Xxfliph/cycloidal-foc-actuator/host/README.md

# Host Tools

Python tools that talk to the actuator over CAN (CANable 2.0 + `python-can`):
- Send position/velocity commands.
- Log telemetry.
- Run automated step tests and plot results.
