Xxfliph/cycloidal-foc-actuator/sim/README.md

# Simulation

Python scripts for:
- FOC simulation (motor model + control loops), used to compare against hardware step responses.
- Cycloid disc profile generation from parametric equations, exported for the SolidWorks equation-driven curve.

Save generated plots to `../docs/img/`.
