Xxfliph/cycloidal-foc-actuator/docs/log.md

# Build Log

One entry per work session. Write what you did, what broke, and what you decided. This becomes the "what broke and how I fixed it" section of the README.

---

## 2026-10-17
- Created repository and folder structure.

## 2026-10-2 to 2026-11-01 Learn FOC
- How a BLDC motor works (3 phases, pole pairs, GM3506)
- Six-step drive vs. FOC
- Core FOC idea: field 90° ahead of the magnet, d–q frame
- Current mode vs. voltage mode (back-EMF, why voltage mode first)
- PI control and cascaded loops
- Clarke and Park transforms (and their inverses)
- Sine PWM vs. SVPWM (+15% voltage, the hexagon)
- Center-aligned PWM on TIM1

## 2026-10-29: CubeMX/CubeIDE setup
- CubeIDE 2.x + standalone CubeMX; G474 project, 8 MHz HSE → PLL → 170 MHz, SWD, HAL tick on TIM6 (FreeRTOS later)
- C++ entry point app_main() in app.cpp
- USB CDC logging (HSI48 + CRS) → COM10
- TIM1 center-aligned 3-ch PWM, ARR 4250 → 20 kHz, verified 25/50/75% in PulseView (Zadig/WinUSB needed for this USB logic analyzer)
- Decided: pin map (PA8/9/10 PWM, PB0 DRV_EN, PA11/12 USB, PA15/PB7 I2C1); avoid PB8 (BOOT0)

## 2026-10-31: MT6701 and I2C test
- My MT6701 breakout doesn’t expose the SSI pins, so I’m using I2C (~8 kHz reads) for now; SSI on the custom PCB.
- I2C1 at 400 kHz on PA15/PB7; bus scan found the MT6701 at 0x06

## 2026-11-01: Writing FOC firmware
- FocController::computeDuties: inverse Park → inverse Clarke → SVPWM (min–max injection) → duties; ±6 V software limit (below the 8.66 V SVPWM max on 15 V)
- MotorDriver: CCR writes, PWM start, enable pin. Kept separate from the math so FocController is testable without hardware
- Verified SVPWM saddle waveforms on Serial Plotter: 154–846 ‰ at vq = 6 V / 15 V bus, matching 0.5 ± (√3/2)·vq/vbus
- Broke: max/min selection used strict `>`, so a two-way tie picked the smallest value as the max. Fixed with `>=`
- Broke: sign error in inverse Park Vβ (would reverse rotation); caught by checking θe = 0
- Broke: local `vbus` shadowed the member; member-name typos (vLimit vs vLimit_)
- Broke: newlib-nano can't printf floats → printed value ×1000 as int (alternative: -u _printf_float)

## 2026-11-02 - 2026-11-03: MT6701 Encoder - Encoder class, multi-turn, velocity

### Raw I2C read
- Angle = 14 bits across two registers: 0x03 = bits 13..6, 0x04 = bits 5..0 (in its upper 6 bits; low 2 bits ignored).
  `count = (reg03 << 6) | (reg04 >> 2)` → 0..16383 per mechanical turn (~0.022°/count).
- One `HAL_I2C_Mem_Read` of 2 bytes from 0x03 (register auto-increments), so both bytes come from the same
  sample. Two separate reads could stitch old + new bytes (~64-count glitch → velocity spike).
- HAL wants the 8-bit address form: 0x06 << 1 = 0x0C (R/W bit goes in bit 0). Plain 0x06 → HAL_ERROR.
- Timeout 5 ms (not HAL_MAX_DELAY) so a stuck bus can't freeze the loop while PWM keeps running.

### Encoder bench results (magnet by hand / taped, motor unpowered)
- Magnet hand-held over chip side: ~50 counts jitter (~1.1° mech ≈ 12° electrical).
- Magnet on back of board (PCB as spacer) or stuck to a header pin: ±1 count = sensor noise floor.
  → Gap and centring matter a lot: design a fixed ~1–2 mm, centred magnet gap into the mount.
- No magnet: random values (±~80 counts) but every read still HAL_OK.
  → "Bus worked" ≠ "data valid". TODO: read MT6701 field-strength status later.
- Turning: sawtooth 0 → 16383, wraps to 0. Screenshot: docs/img/<sawtooth>.png

### Encoder class (firmware/actuator_fw/Core/{Inc,Src}/encoder.*)
- `Encoder(I2C_HandleTypeDef* hi2c, uint8_t addr)`: takes the datasheet 7-bit address, shifts once in the
  initializer list.
- `update()`: one I2C read per call; updates state only on HAL_OK (keeps last good value on failure);
  returns the HAL status. Getters are const and never touch the bus, so each loop reads once and every
  user sees the same sample.
- `getRawCount()`, `getAngle()` (rad, 0..2π), `getMultiTurnAngle()` (rad, unbounded),
  `getRawVelocity()`, `getVelocity()` (filtered, rad/s).

### Multi-turn (unwrap)
- diff = new − prev (as int32_t); if diff > 8192 → −16384; if diff < −8192 → +16384; else unchanged.
  Always assumes the shorter way round, so the shaft must move < half a turn between reads
  (10 ms loop → max 50 rev/s; faster loop raises the limit). Threshold must be exactly half a turn.
- totalCount_ (int32_t) accumulates corrected diffs. First good read seeds prev/total (no fake jump).
- Verified: multi-turn angle climbs/falls smoothly across wraps, goes negative past start.

### Timing: DWT cycle counter
- Enabled once in app_main: `CoreDebug->DEMCR |= TRCENA`, `DWT->CTRL |= CYCCNTENA`.
  Read `DWT->CYCCNT` (170 MHz, ~6 ns resolution, wraps every ~25 s; unsigned subtraction handles the wrap).
- Measured loop period: ~1,870,000 cycles = 11.0 ms, not 10 ms (HAL_Delay adds a tick).
  Assuming 10 ms would have made velocity ~10% wrong → always measure Δt.

### Velocity
- velocity = (unwrapped diff → rad) / Δt, Δt = Δcycles / SystemCoreClock (float). Guard Δcycles > 0
  (avoids NaN, e.g. if the counter was never enabled).
- Still test: raw velocity is exactly 0 / ±34 mrad/s = ±1 count per 11 ms ((2π/16384)/0.011 ≈ 34.9).
  Matches prediction → angle conversion and Δt are correct.
- No-magnet test: ±4000 mrad/s (≈ ±115 counts per sample) → velocity amplifies angle noise.
  Faster loops make this worse (1 count at 1 kHz ≈ 380 mrad/s).

### Velocity low-pass filter (EMA)
- filt += α·(raw − filt), with α = Δt / (τ + Δt), τ = 20 ms. α recomputed each update from the measured Δt,
  so the reaction time stays ~τ regardless of loop rate or missed reads.
- At 11 ms: α ≈ 0.355. Still-test noise ±34 → ~±15 mrad/s; first step = 0.355 × 34 ≈ 12 and
  decay ×0.645 per step, both match the plot.
- Hand-spin test: filt is smoother, lags raw by ~1–2 samples (~20 ms), and shaves peaks
  (4200 → 3800, −6900 → −5800). Trade-off: bigger τ = smoother but laggier.
  Screenshot: docs/img/<raw_vs_filt>.png

## 2026-11-03 - 2026-11-04: First spin, calibration, closed-loop code

### Electrical angle (FocController)
- Added pole pairs, offset and direction to FocController (Encoder stays a pure sensor).
  `electricalAngle(mech) = fmodf(mech·11·dir − offset, 2π)`, +2π if negative.
- Verified by hand: elec = 11 × mech (mod 2π) at 5 positions.

### Dev rig + first open-loop spin (WARG bay bench supply)
- Keysight EDU36311A CH2: 12 V, 0.5 A limit → SimpleFOC Mini +/− screw terminal.
  Signals: PA8/PA9/PA10 → IN1/IN2/IN3, PB0 → EN, common GND. nRT/nSP/nFT/3.3V unconnected.
- Power-up with driver disabled: 11 mA.
- Open loop (vd 0, vq 1.5 V, θe +0.07 rad/loop): smooth spin, ~0.10 A. Reverse works.
- Stutters below vq ≈ 0.3–0.4 V (friction/cogging).
- Habit: supply output OFF before every flash.

### Encoder on the motor
- First try: flat encoder reading → magnet was on a part that doesn't rotate.
  Magnet must spin with the rotor, centred on the axis; chip fixed, facing it.
- Open-loop ramp vs encoder: same slope and direction → direction +1, 11 pole pairs.

### Calibration
- Hold vd at θe = 0 for 1 s, read encoder → offset; setCalibration(offset, +1).
- Mistake 1: calibrated with motor power off (firmware runs right after flashing) → wrong offset.
  Fix: output ON, then press NRST.
- Mistake 2: vd = 1.5 V too weak → friction/cogging left the rotor ~0.9 rad (electrical) off.
  Fix: calibrate at vd = 2.5 V.
- Verified: holding θe at 0 / π/2 / π / 3π/2 → encoder read 0 / 1570 / 3141 / 4712 mrad
  (within ~1 mrad). Offset ≈ 1.1 rad.

### Closed-loop voltage-mode FOC (written, compiles, not yet tested)
- Calibrate at boot (fail → driver off, print "cal failed"), then loop with no delay:
  encoder → θe → computeDuties(vd 0, vq 1 V, θe) → setDuty.
- 20 consecutive failed encoder reads → driver off (latched until reset).

### Encoder magnet choice
- Noise test (spread = max − min over 50 still reads):
  - off-centre, next to a steel header pin: big magnet 20–30, small 60–80
  - centred on the back of the board (~1.6 mm gap): big 0, small 2
- → Using the bigger magnet.
- Mount plan: magnet flush in the shaft end (printed centring)
  MT6701 centred under it at ~1.5–2 mm. Quick bracket/tape rig for now;
  final encoder placement comes with the custom PCB.

### PIController
- `PIController(kp, ki, outLimit)`, `update(error, dt)`, `reset()`.
  Caller computes the error, so it works for the velocity and position loops.
- update(): if dt > 0 → integral += Ki·e·dt, clamped to ±outLimit;
  output = Kp·e + integral, clamped to ±outLimit.
- Anti-windup: clamp the integral itself, not just the output.
  Otherwise a stuck rotor winds it up far past the limit and the motor stays at full vq after release.
- if dt ≤ 0 → skip integration only. reset() → integral = 0 (call after calibration / any disable).

## 2026-11-04 - 2026-11-05: Velocity loop, closed-loop FOC on hardware, tuning

### Velocity loop code
- Velocity PI runs every ~1 ms; FOC runs every pass with the latest vq.
  Timing: lap timer on DWT->CYCCNT (elapsed = now − last, uint32 handles the ~25 s wrap);
  dt = elapsed / 170e6 (measured, not assumed).
- error = target − getVelocity(); vq = PI.update(error, dt). vq and target declared
  before the loop so they persist between passes.
- Step command: target 0 until STEP_DELAY_MS after loop start (HAL_GetTick), then 10 rad/s.
- USE_VELOCITY_LOOP switch: false = constant VQ (FOC test), true = PI sets vq.

### Encoder placement test
- Test app.cpp: per 50 reads prints count, spread (still noise), max jump, direction flips, I2C errors.
- Still: spread 0. Full turn: smooth count, no jump spikes, err 0.
- Flips only when nudging by hand (cogging snap-back); continuous spin → 0 flips. Passes.

### Closed-loop voltage-mode FOC (first hardware test)
- VQ = +1 V: spins by itself at ~17.6 rad/s. VQ = −1 V: ~−17.9 rad/s. Symmetric.
- Slow ±1 rad/s ripple, ~once per revolution (mechanical/placement, not firmware).
- Mistake: vLimit 2 V clipped calibration's vd 2.5 V (computeDuties clamps vd too).
  Fix: FocController vLimit 3 V, PI limit 2 V as the safety cap.
- "cal failed" after an NRST: MT6701 I2C bus stuck (encoder stays powered through NRST).
  Fix: full power cycle (unplug motor power + STM32 USB).

### Velocity loop tuning (step 0 → 10 rad/s)
| Kp  | Ki | Peak | Settles | Notes |
|-----|----|---|---|---|
| 0.1 | 0  | 6.7  | 5.7 | vq 0.42 V = Kp·e (P-only balance point)  |
| 0.2 | 0  | 9.4  | 7.5 | vq hits 2 V limit at the step |
| 0.4 | 0  | 11.8 | 8.6 | rings, vq goes negative (braking) |
| 0.3 | 3  | 11.6 | 10.0 ± 0.35 | chosen: ~16% overshoot, on target ~0.2 s |
- P-only overshoot comes from lag (EMA τ 20 ms vs ~25 ms rise) → limits Kp.
- Integral learns the steady push: vq ~0.6–0.7 V at 10 rad/s, P ≈ 0.
- Pinch test: speed dips, recovers to 10 while still pinched.

## 2026-11-04 - 2026-11-06: PCB prep — DRV8316 datasheet, requirements, parts, pin plan

### DRV8316 datasheet
- Went through pins + typical application, PWM modes, current sensing, variants, thermal pad.
- Learned along the way: FETs and half-bridges, why the high side needs a charge pump,
  decoupling vs bulk caps, buck vs LDO, pull-ups, open-drain, floating inputs, zener clamps.

### Key decisions
- 3.3 V from the DRV8316's buck at its default 3.3 V, straight to the STM32 (47 µH inductor, ~72 mA budget).
- nSLEEP woken from VM (10 kΩ + 3.3 V zener), not connected to the STM32 → firmware can't cut its own power.
- 3x PWM mode: TIM1 CH1–3 → INHx (same as dev rig), all INLx on one enable GPIO.
- DRV8316CR (newer "C", better current-sense amps) + STM32G431CBT6 (LQFP-48, hand-reworkable).
- MT6701 goes on the main board, centred over the magnet; board screws to the motor's 4 stationary back-face holes.
- JLCPCB assembles the SMD parts (thermal pad can't be done with an iron); quote PCBWay too (student 50%).

### Mistakes caught (datasheet re-check)
- nSLEEP pull-up to AVDD wouldn't work: AVDD is off while the chip sleeps → chicken-and-egg. Fix: from VM + zener.
- nFAULT pull-up to the buck rail: chip can enter test mode if the pull-up supply is < 2.2 V at power-up. Fix: to AVDD.
- VREF from the buck rail: VREF must not exceed AVDD. Fix: VREF → AVDD.
- Current-sense gain: lowest gain (0.15 V/A) is too coarse for ~1 A → firmware setting, likely 0.6 V/A.
- Bulk cap: small electrolytics can't take the PWM ripple current → added 2× 10 µF ceramics.

### Parts + pin plan
- All parts picked with LCSC numbers (chips, power, input protection, crystal, connectors); passives as Basic parts at BOM time.
- CubeMX pin plan (`hardware/pinplan/pinplan.ioc`): CAN on PB8/PB9 + USB on PA11/PA12 both fit.
  BOOT0 clash on PB8 solved with option bytes (nSWBOOT0 = 0, nBOOT0 = 1), same as ST's B-G431B-ESC1.
- Clocks same as dev rig (8 MHz HSE → 170 MHz), USB from HSI48 + CRS, FDCAN from PCLK1.

## 2026-11-06 - 2026-11-07: Motor measurements, board outline, Altium project

### Motor back-face measurements (calipers)
- Back face Ø40 mm. 4 stationary mounting holes, **M2.5**, on a **24.0 × 24.0 mm square**
  (34.0 mm diagonal; centre-to-centre = average of near-edge and far-edge readings). ~6.3 mm usable thread.
- Magnet 0.1 mm sticking out. Everything else flush, except the motor wires leaving the recessed pad pocket
  (pocket sits midway between two holes).

### Mounting decision: low mount, MT6701 on top
- Board sits 1 mm above the motor face on nylon M2.5 washers (no standoffs), M2.5 × 8 mm stainless/nylon screws.
- MT6701 on the top side, centred over the magnet. Magnet → die ≈ 1 + 1.6 − 0.1 + ~0.75 ≈ 3.25 mm.
  The passing 2.8 mm paper test had the die at ~3.55 mm (chip faced the magnet), so the board is closer.
- Why a gap at all: the magnet sleeve spins, through-hole legs poke out the bottom, and the motor face is metal.
- Rules: no through-hole legs inside the Ø40 motor circle; motor wires go up through a window in the board
  (shortened), never out over the rim under the board.
- Board Ø50 mm: Ø40 is too tight for single-sided parts + routing, and the overhang ring holds the
  through-hole connectors. 50 mm = largest round board inside the planned ~60 mm housing → re-check after the cycloid CAD.

### Board outline (Onshape)
- Built on a downloaded GM3506 model, checked against the caliper numbers.
- Ø50 board, 4 holes on the 24 × 24 mm square, ~8 × 13 mm window over the motor pads, MT6701 box at the centre.
- Exported `hardware/outline/board-outline.dxf` (outline + holes + window) and `board-on-motor.step` (fit check later).

### Altium project
- `hardware/altium/actuator-driver/` (local project): PrjPcb + SchDoc + PcbDoc.
- Imported the DXF, set the origin at the board centre (outline arc reads centre 0,0, radius 25 mm),
  defined the board shape from the circle and the window as a board cutout.
- Mounting holes: 4 unplated drilled pads MH1–MH4, 2.7 mm, at (±12.021, ±12.021) mm.
- Mistakes: origin was ~0.4 mm off the centre after import → fixed with arc-centre snapping and checked by number.
  First made the 4 holes as routed cutouts → redone as drilled holes (standard, more accurate).

## 2026-11-07 - 2026-11-08: Part libraries

### Setup
- Project libraries `actuator-driver.SchLib` + `.PcbLib`. Downloaded parts (Ultra Librarian, Altium Manufacturer
  Part Search, EasyEDA export) go in a downloads folder, get checked, then copied in.
- Every footprint checked against the maker's land pattern. Solder mask expansion 0.05 mm on every pad.

### Chips
- DRV8316C: Ultra Librarian footprint was wrong (pads too long, thermal pad too big, 0.14 mm gap to signal pads).
  Fixed to TI's pattern: 0.25 × 0.6 mm pads, 3.7 × 5.7 mm thermal pad, 0.25 mm gap, TI's 12 paste windows (69%).
- STM32G431 (ST's recommended LQFP-48), SN65HVD230 (TI D0008A), MT6701 (same SOIC-8 footprint as the SN65).

### Discretes and connectors
- AO3401A (gate limit ±12 V, so the 10 V zener clamp is fine), SMBJ18A (pin 1 = cathode = band).
- Drew by hand from datasheets: BZT52 zeners (SOD-123; Altium only had SOD-323), PTC 1812, 8 MHz crystal (2-pad),
  47 µH inductor, SWD header, test pad, solder jumper, motor pads (2.0 × 3.0 mm, 3 mm pitch).
- EasyEDA exports (checked): 47 µF cap (pad 1 = +), JST GH CAN connector.
- Generic RES/CAP/FB parts (Comment = value): 0603 R/C share one footprint, plus CAP_0805 and CAP_1206. LED_0603 (pad 1 = cathode).
- Swapped the XT30 for a 2-pin 3.5 mm screw terminal. Power comes from the PD trigger (15 V) through an 18 AWG lead with the 2 A fuse.

### Other
- Accidentally cut a motor wire; 10+ cm left, so re-strip and reconnect.
- Set up the Salitronic EDA agent: Claude can read/check Altium directly. Both libraries pass Altium's rule checks
  (only duplicate outline lines on the DRV8316's Mechanical 13 layer, harmless).
- Before layout: board rule Mask → Solder Mask Expansion = 0.05 mm (the AO3401A uses the rule).
- Next: schematic.

## 2026-11-08 - 2026-11-09: Datasheet check + schematic

### Datasheet check (before drawing)
- Re-checked every part and circuit choice against the maker's datasheet; page numbers are in `hardware/requirements.md`.
  The STM32 (48 pins) and DRV8316 (41 pins) symbols match the datasheets.
- Fixes:
  - nFAULT moved PB2 → PB11. PB2 only tolerates 3.6 V, but nFAULT is pulled up to AVDD, which can sit above the 3.3 V rail.
    PB11 is 5 V-tolerant. Updated `pinplan.ioc` (EXTI11, falling edge) and checked it in CubeMX.
  - VBAT → 3.3 V (it was left unconnected; the datasheet says it must be connected).
  - Crystal caps 30 → 20 pF (worked out from the crystal's load capacitance).
  - Current-sense filter cap 2.2 nF → 220 pF; with the 330 Ω this is fast enough for 20 kHz PWM.
  - AVDD cap rated ≥ 16 V, because a ceramic cap loses capacitance under voltage.
- Corrections to my notes: the 47 µH inductor must handle more than the 900 mA buck current limit (it's rated 1.1 A, OK);
  the MT6701 needs 32 ms after power-up before it reads correctly; the DRV8316 SDO pin is push-pull after reset.
- Library cleanup: removed junk parameters, set maker + LCSC numbers on the zeners and the TVS, named the 47 µF cap pins +/-.

### Schematic (6 sheets, global net names)
1. Power input: screw terminal → PTC → P-FET reverse protection → TVS → bulk caps → VM; VM sense divider ÷11.
2. DRV8316: buck to 3.3 V, charge pump caps, nSLEEP from VM (10k + 3.3 V zener), nFAULT 5.1k to AVDD,
   VREF to AVDD, PGND and GND joined by a 0 Ω net-tie (R4).
3. STM32: decoupling caps per the datasheet, ferrite bead to VDDA, 8 MHz crystal, 330 Ω + 220 pF filter on each current-sense
   signal (SOx → SOx_ADC), status LED (PB10), power LED.
4. Encoder: MT6701 over SSI (SPI2, receive only).
5. CAN: SN65HVD230, 120 Ω terminator behind a solder jumper (open by default).
6. Connectors: 2× JST GH CAN, SWD header, motor pads, test pads.
- Mistakes caught while drawing (worth remembering): reversed diode, PGND/GND mixed up, caps accidentally in series,
  power ports used for signals (use net labels), a power port left a cap pin floating, a shorted crystal, a filter that was
  bypassed by a net name, SOA/SOC swapped.
- Claude checked the full netlist (241 pin connections) against the requirements, and it matches.
- Compile is clean. No ERC on: USB_DM/DP (USB-C not decided yet), CAN_RX/DRV_FAULT/DRV_MISO (Altium flags IO vs Output,
  which is fine here), and nSLEEP (it's driven by a resistor, not a chip pin).

## 2026-11-09 - 2026-11-10: Placement + placement review

### Getting the parts onto the board
- Design → Update PCB Document. First try did nothing: Validate only checks the changes, Execute is what adds them.
- Rooms off. Parts pulled in one sheet at a time with Cross Select Mode + Tools → Component Placement → Arrange Within Rectangle.

### Placement
- All 69 parts on the top side; board origin = centre, motor-wire window at 12 o'clock.
- U3 (MT6701) at the exact centre over the magnet; U1 (DRV8316) to its right with the OUT pins facing the motor pads
  (J5 pads in the same OUTC/OUTB/OUTA order as U1, no crossings), U2 (STM32) to its left, CAN at the bottom,
  power input lower right (J1 → F1 → Q1 → TVS → 47 µF → 10 µF next to the VM caps).
- Rules used: through-hole pins ≥ 21 mm from centre (motor face is Ø40, legs clipped flush), copper ≥ 0.3 mm from the edge,
  nothing near the mounting holes.
- JST GH side-entry: the small signal pads are at the back and the opening is on the big-tab side (JST datasheet).
  J2/J3 were facing inward at first → rotated 180°.

### Placement review (Claude, independent; full write-up in the project doc `pcb-placement-review.md`)
- Mounting-hole keepouts were drawn inside the holes (r 1.2 < hole r 1.35), so they protected nothing. Measured the screw
  heads (Ø4.7) → keepouts now r 2.8. Moved Q1 (its VM pad was under the screw head), TP1 and J3 off the holes.
- DRV8316 pins 5–8 (SW, CPL, CPH, CP) couldn't all be routed on top: C13 sat right in front of SW. Changed C13 to 0402
  (new CAP_0402 footprint + symbol, LCSC C307339), lined it up with pin 7, moved C11 onto pin 8's line and shifted the
  VM caps and R4 up. SW now has a straight path to the inductor.
- AVDD cap C12 was 6 mm from its pin (sitting next to the VREF cap instead) → moved next to pins 25/26.
- R5/R7 were in the path of the three motor-phase traces → moved next to the DRV8316 pins they connect to.
- Rotated U3 180° so its SPI pins face the STM32 (no crossing). Only changes the zero offset, which calibration measures.
- Crystal rotated 90° so OSC_IN/OSC_OUT don't cross; R9 in line with pin 6.
- J1 pulled 0.65 mm in (overhang 1.6 → ~1 mm), small VDDA caps swapped to be nearest the pins.
- Left as is: C17 (no room between the hole and the STM32), current-sense resistors (routable as is).
- Re-check of the whole board is clean (pad gaps, outlines, holes, edge).

### Other
- Altium caches libraries: the new footprint showed "Footprint Not Found" until I reopened the project.
- From the PCB, schematic changes come in with Design → Import Changes From <project>, NOT "Update Schematics".
- The ECO also listed 4 "Unavailable footprint" lines (Q1, U2, U3/U4, D2): same footprints, accepted, nothing moved.
- Housing notes: J1/J2/J3 need slots in the wall; rear cover needs ≥ 9 mm clear above the board
  (J1 8.8 mm, SWD header 8.5 mm, 47 µF 7.7 mm).

## 2026-11-10 - 2026-11-11: Stackup, rules, pours + routing (sections 1–5)

### Stackup, rules, ground pours
- 4 layers, JLC04161H-3313 (1.6 mm): Top / L2 GND / L3 signals + power / Bottom. Thin 0.1 mm prepreg so Top sits close to the L2 ground.
- Net classes: PWR_RAIL (VM, PGND, VIN), MOTOR_OUT (OUTA–C), SW, LOGIC_PWR (3V3, AVDD, VDDA). Clearance 0.15 general,
  0.2 for power nets and vias, 0.35 around the hand-soldered J1/J4. Vias tented on both sides (the bottom faces the motor).
- GND pours on L2 + Bottom with a PGND island under the power section (input, VM caps, motor-phase corridor),
  joined to GND only at the R4 net-tie. Remove Dead Copper is off on the PGND pours until the PGND vias exist.
- Mounting-hole keepouts on every copper layer; pin-1 dot added on U1.

### Routing
- DRV8316 corner: charge-pump caps and SW on Top with no vias (C13 is 0402 so CPL can pass under it and CP over it).
  The buck feedback (FB) moved to the right side to free the space under the current-sense pins.
- VM: a fill joins VM pins 9–11 to the first cap. The two cap columns are separated by a PGND column, so VM crosses
  between them on L3 through VM vias. 15 thermal vias in the DRV8316 pad.
- Motor phases: 0.5 mm, not the planned 0.8 (0.8 didn't fit between the pin pairs, the PGND vias, the screw-head ring
  and the PGND island edge). 0.5 mm carries ~2 A for ~10 °C rise; the motor needs ~1 A. The top bend of OUTA has to
  stay ≥ 3.25 mm from MH1's centre (keepout ring + power clearance); the first version failed DRC by 0.05 mm.
- Power input routed at 1.0 mm with PGND vias. Crystal on Top only, no vias, nothing else nearby.
- Current sense: SOA/SOB/SOC on L3 to the 330 Ω resistors at the left edge. The filtered nodes (R → 220 pF → ADC)
  run on Top through the 0.57 mm gaps between the resistor/cap rows (a via never fits in a gap, a 0.15 mm trace does).
  The cap grounds had to become vias in the middle of the pads (via-in-pad); decide at ordering whether to pay for
  plugged vias.
- Last DRC: 0 clearance/short errors; 90 nets left to route; silkscreen items unchanged.

### Lessons
- Repour after adding vias: old pours run straight through new vias and DRC reports them as shorts.
- A via that only touches a pad edge isn't connected — draw a trace.
- Keepout rings are checked with the normal clearance rules, so power traces need keepout + 0.2 mm.
- Check where the neighbouring vias are before picking a via spot (one suggested spot landed on another via).
- Running a thick trace straight through the middle of an inner layer walls it off for every signal that has to cross.

## 2026-11-11 - 2026-11-13: Routing finished (sections 6–8), fab outputs, review, JLC order placed

### Routing
- DRV SPI, INH/PHASE_EN/DRV_OFF/nFAULT and encoder SPI routed, mostly on L3 with short Top fan-outs.
- CANH/CANL routed as a 0.2 mm pair. Impedance control isn't needed on ~1 cm of trace.
- SWD runs ~10 cm around the board on L3. (Later check: it crosses the PGND islands, see "GND / PGND split check".)
- LEDs and UART routed. Every STM32 GND pin gets its own short via to the ground plane.
- 3V3 had a ratsnest line between two islands. There's only one 3V3 source (the DRV8316 buck, L1 → C15),
  so the two islands had to be joined.
- 7 GND vias were shorting L3 traces (INHB, 3V3, SOA, VM, UART_TX), because vias go through every layer.
  Moved them next to C12/C19/C14/C30/C31/D3/U4 pin 2.
- SO vias at x −22.25 needed Top stubs to the resistor inputs. They aren't dead ends.

### Pours, stitching, Remove Dead Copper
- GND stitching vias added around the board, none under the crystal.
- Remove Dead Copper stays OFF on the PGND pours. The island is made of 9 overlapping rectangles, each
  rectangle is judged on its own, and turning it on deleted the whole island. The merged copper is one
  piece with plenty of PGND vias, so nothing is actually floating.

### DRC and board sweep (EDA tool, beyond DRC)
- 0 unrouted, 0 shorts, 0 clearance/width/via errors. Schematic vs PCB matches (69/69). ERC 0.
- Accepted leftovers (30 after the OUTB fill): silk-to-mask (footprint outlines on pads), 1 silk-to-silk,
  board-outline, net antennae (thermal-pad GND vias).
- Silkscreen 1 mm height / 0.15 mm stroke; small passives' designators hidden where they sat on pads.
  J1 overhangs the board edge by ~0.96 mm on purpose (connector lip).
- Netlist: no floating pins; the 18 single-pin nets are all intentional (NC pins, spare GPIO, MT6701 OUT/PUSH,
  SN65 Vref, USB not fitted, J2/J3 pin 1). Every pour is one piece per layer.
- Component Clearance rule wasn't in the DRC → enabled: 0. The placement-audit overlaps (R3/J4, F1/J1,
  U4/J3) were bounding-box false alarms; 3D view agrees.
- Real short found: a UART_TX via sat inside the GND pours on L2/Bottom (pours not redone after the via was
  added). Repour All fixed it. The first Gerbers would have shipped with UART_TX shorted to GND.

### Fab outputs (hardware/fab/)
- Gerbers in mm 4:4, 11 layers, board centre = (0,0) in every file, drill files line up. NC drill mm 4:4,
  plated / non-plated separate. Re-exported after every save.
- actuator-driver_gerbers.zip (Gerbers + drill), actuator-driver_BOM_JLC.csv (LCSC numbers),
  actuator-driver_CPL_JLC.csv (Altium pick-and-place, mm from board centre), actuator-driver_BOM_PCBWay.csv.
- Small-part picks: all 100 nF = 50 V (C14663, the VM caps need it), 1 µF = C15849 (50 V X5R), 220 pF filter
  = C1603 (X7R, not C0G — free Basic part, fine at 2 MHz cutoff), 20 pF C0G = C1648, ferrite GZ1608D601TF
  (C1002, 200 mA), resistors UNI-ROYAL 0603.
- Stock: LED C72043 out of stock → final pick KT-0603YG (C2289). J2/J3 short by one → J3 not assembled
  (J2/J3 are in parallel; hand-solder J3 later for daisy-chaining). Assemble 2 boards, not 5.

### Pre-order review (fresh eyes)
- Checked against datasheets: power path, polarity of every diode/LED/electrolytic, pin 1 of every IC, U1 footprint
  vs TI's land pattern, MT6701 / SN65HVD230 / STM32 pinouts.
- Scanned the actual Gerbers for every one of the 249 pads: copper, mask opening, paste, gaps, slivers, annular ring.
- Similar projects (MicroSpora DRV8316 + STM32G431 thread and other open-source FOC boards): every hardware problem
  they hit is already handled here — DRVOFF pull-up, buck feeds 3.3 V direct (no diode/LDO), BOOT0/PB8 via option
  bytes, crystal series resistor, separate SPI buses, SWD header, nSLEEP wake, thermal vias.

### Fixes before ordering
- Q1 (AO3401A) and C13 had NO solder-mask openings: their pads were on mask "from rule", which covered them.
  Set to manual 0.05 mm expansion. Found from JLC's preview showing no Q1 pads; the first scans only checked
  copper and drill, which is why it was missed.
- Closed a 0.04 mm copper sliver at U1 pin 16 with a small Top fill (OUTB).
- PCBWay's audit found a 0.05 mm gap between two 1 mm PGND traces on L3 (left of C1). Same net, so DRC ignored
  it, but a fab can't etch it. Deleted the redundant short trace (its vias stay connected through the PGND
  island on L2/Bottom), repoured.
- Final vias: 81 small vias at 0.3 mm hole / 0.45 mm pad (ring 0.075). Avoids JLC's small-via + 4-wire Kelvin
  test fees (~$33.5). Annular ring rule set to 0.07 (exactly-at-limit values were flagged by rounding).

### Second opinion (another AI, given the Gerbers/BOM/CPL)
- Its own pad-by-pad Gerber check agreed: every pad has copper, mask and paste.
- Its two "critical" findings were wrong: MT6701 MODE high = I2C/SSI (the dev-rig breakout has MODE at VDD and runs
  I2C), and the SMBJ18A complaint came from the handoff saying 12–24 V. The design is 12–15 V.
- Everything else was already known or harmless (BOOT0 via option bytes, J3 not assembled on purpose, L2 and
  Bottom both GND pours, 0.075 mm via ring OK with epoxy-filled vias).

### GND / PGND split check
- Checked every L3 and Top signal trace against the 9 PGND islands. Only SWDIO and SWCLK cross the split.
  All motor-control signals (DRV SPI, INHx, PHASE_EN, SOx, encoder SPI, CAN, UART) are over solid GND.
- Accepted for rev 1: if SWD is flaky, lower the ST-Link clock (≤ 1 MHz); worst case, solder wires straight to
  the PA13/PA14 legs.

### Quotes and fab choice
- PCBWay (4 layers, S1000H TG150, 5/5 mil, 0.3 mm min hole, HASL lead-free): its human audit caught the L3 gap.
  Student program = 50% of board + assembly labour only (not parts, shipping, duties) and needs "PCBWay" on the
  silkscreen → not used. Chose JLC (only a bit more expensive, faster).
- JLC: the 3313 stackup doesn't allow Economic assembly → default stackup is fine (no impedance-controlled traces).
  Customs description: DIY Hobby Circuit Board (HS 902300).
- Placement preview: all ICs (U1–U4) rotated 90° CW and Q1 180° by hand to match the pin-1 dots and pads.
  Diode polarity checked against pad nets: D1 cathode on VM pad (top), D2 cathode on VM pad (left),
  D3 cathode on nSLEEP pad (right), D4/D5 cathode on GND pad (left); Q1 pin 1 = gate.

### JLC order (W2026111309131766), paid Nov 13, In Production
- PCB: 5 pcs, 4-layer, 1.6 mm, ENIG, Epoxy Filled & Capped vias (13 small pads have via-in-pad, incl. the
  current-sense caps), flying probe, JLC mark removed. PCBA: Economic, top side, 2 assembled, nitrogen reflow,
  assembly remark for polarity.
- Review Before Payment; approved in ~3 h (PCBA review takes longer than PCB).
- Paid US$139.17 (boards $124.17 + DHL $15) after the shipping coupon and JLCONE discount; about C$185.
  Expect Canadian tax (~C$25–35) from DHL before delivery.
- Still to do: confirm the production-file and parts-placement previews when JLC sends them.

### Rev 2 list
- Route SWD over solid GND (avoid the PGND islands).
- Set the AO3401A and CAP_0402 library footprints to manual 0.05 mm mask so the Q1/C13 fault can't come back.
- Crystal load caps: 20 pF gives ~14 pF effective vs the crystal's 20 pF → 30 pF would be closer.
- Optional: silkscreen labels (+/− J1, A/B/C J5, CAN, SWD, name/version), VM stub to the via at 0.4 mm,
  C2/C3 PGND stubs at 0.5 mm or a second via.

### Before bring-up
- Buy: CP2102 or CH340 USB-serial adapter (3.3 V), JST GH 4-pin pre-crimped cables (check pin order vs the CANable).
- Board runs on 12–15 V only (TVS starts conducting ~20 V).
- First power-up: 12 V, 50 mA limit, no motor; check 3.3 V. Then set option bytes nSWBOOT0 = 0, nBOOT0 = 1.
- Firmware: BUCK_PS_DIS = 1 first; NEVER set the DRV8316 buck to 5 V (SimpleFOC examples do; it feeds the
  STM32 here); read back registers after writing (a constructor flag didn't set PWM mode in MicroSpora);
  ADC at the PWM centre, cap the duty.

### Lessons
- Check what's on L3 before placing a via. A GND via on an L3 trace is a short.
- A ratsnest line means two copper islands of the same net aren't joined. Join them anywhere.
- The tool's "unrouted" list can be stale; trust the DRC counts.
- Repour after any via change, and re-export after any save.
- DRC ignores pad-to-pad gaps inside a footprint and gaps between same-net copper; a fab's CAM check doesn't.
- Check mask and paste from the Gerbers too, not just copper: a pad on "mask from rule" can end up covered.
- Turn on the Component Clearance rule; it wasn't checked by default.
- Zeners/TVS face backwards on purpose: the cathode goes to the higher voltage. Orient diodes by the pad nets,
  not by "GND = −".
- Fab part models can be 90° off from the footprint: check every IC's pin 1 in the placement preview.
- A manufacturer's "approved" means they can build it, not that the circuit is right.
