Xxfliph/cycloidal-foc-actuator/docs/img/closed loop reverse direction.png

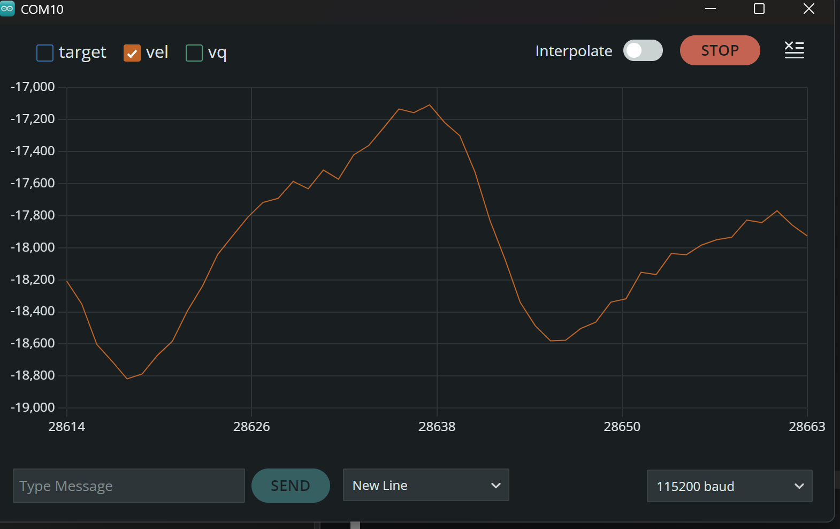
docs/img/closed loop reverse direction.png
