Xxfliph/cycloidal-foc-actuator/docs/img/first closed loop spin.png

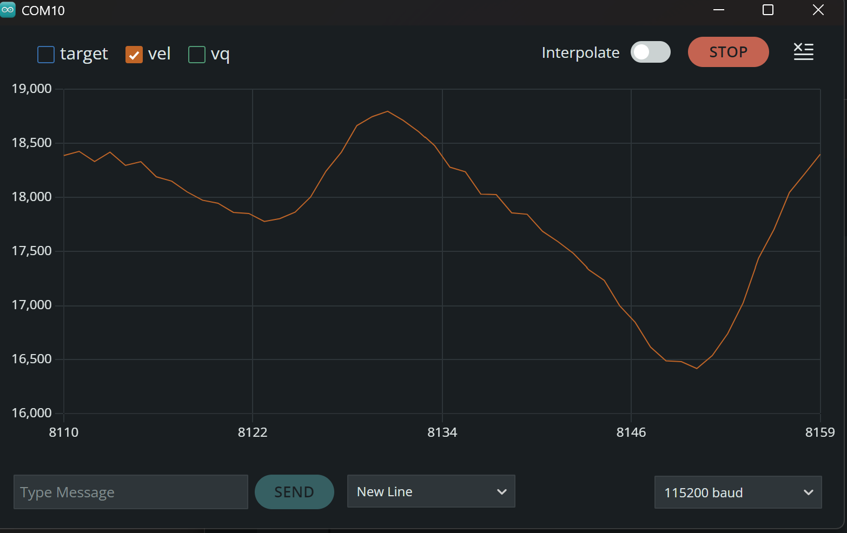
docs/img/first closed loop spin.png
