Xxfliph/cycloidal-foc-actuator/docs/img/Kp = 0.1.png

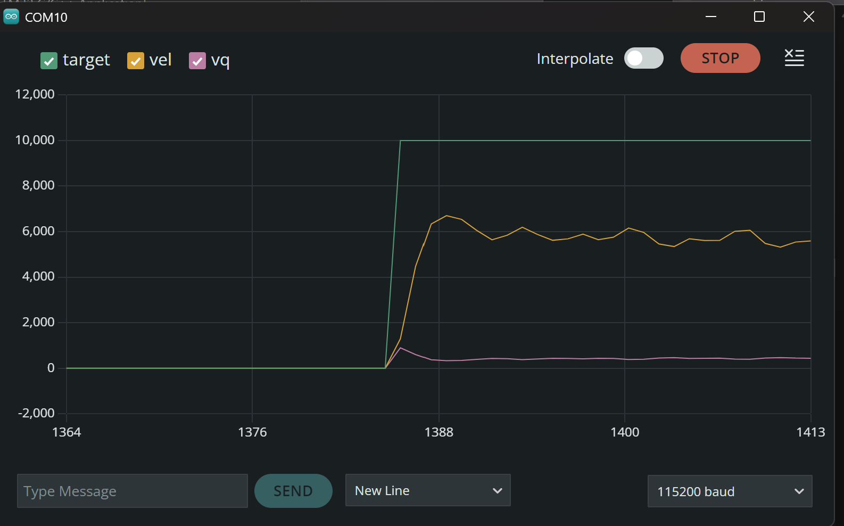
docs/img/Kp = 0.1.png
