Xxfliph/cycloidal-foc-actuator/docs/img/Kp = 0.2.png

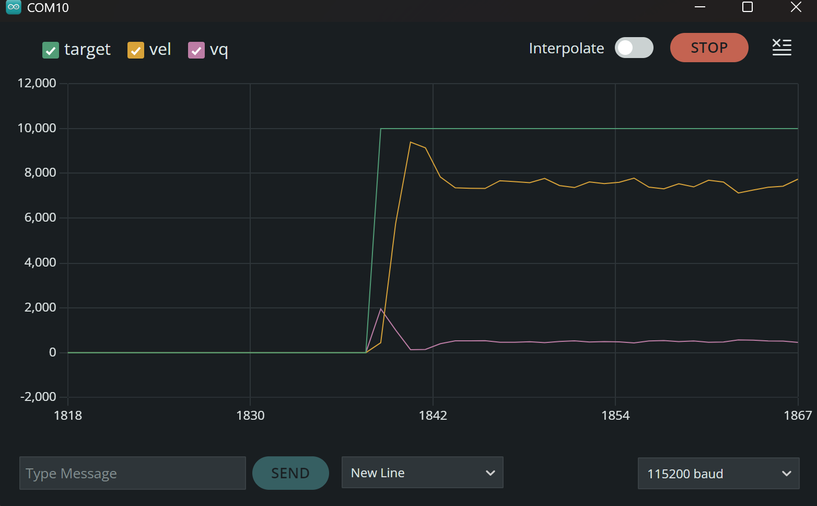
docs/img/Kp = 0.2.png
