Xxfliph/cycloidal-foc-actuator/docs/img/Kp = 0.3, Ki = 3.0.png

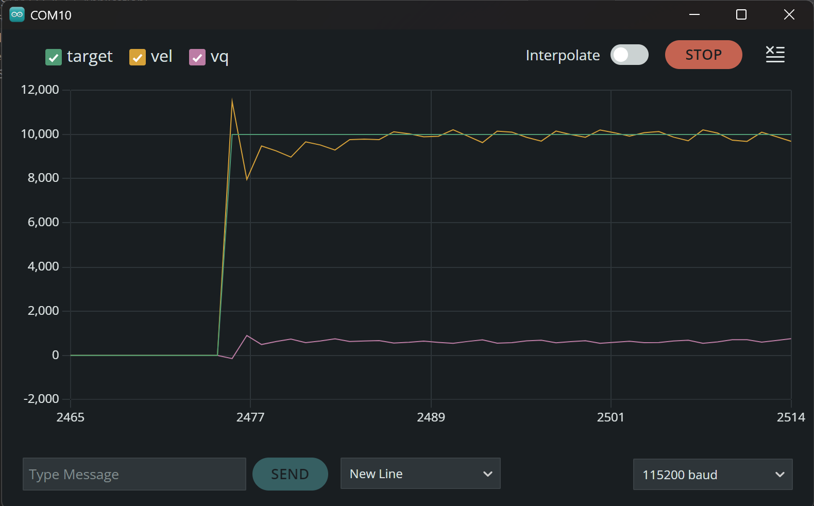
docs/img/Kp = 0.3, Ki = 3.0.png
