Xxfliph/cycloidal-foc-actuator/docs/img/svpwm-duties-plotter.png

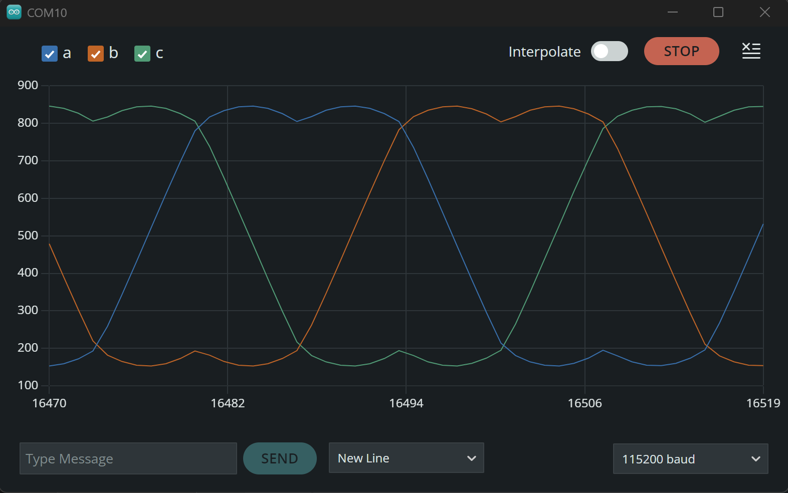
docs/img/svpwm-duties-plotter.png
