Xxfliph/cycloidal-foc-actuator/docs/img/tim1-pwm-pulseview.png

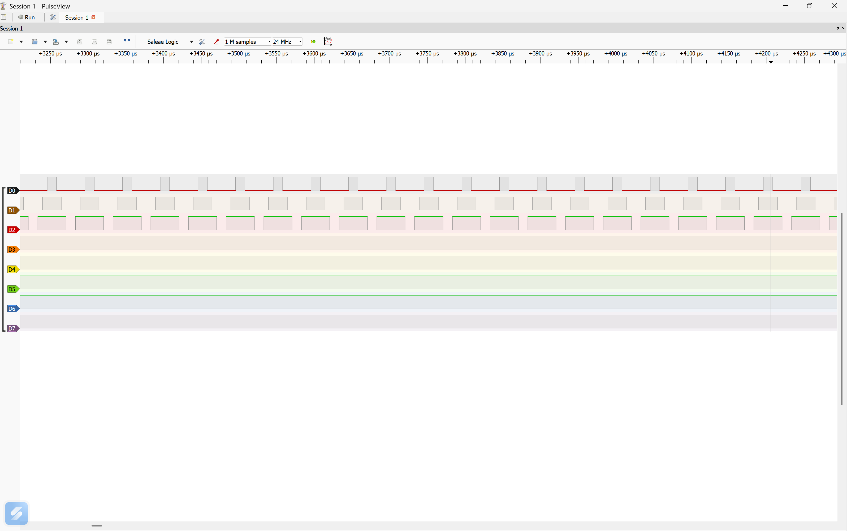
docs/img/tim1-pwm-pulseview.png
