Xxfliph/cycloidal-foc-actuator/hardware/fab/actuator-driver_BOM_JLC.csv

Comment | Designator | Footprint | LCSC Part #
47uF 50V electrolytic 6.3x7.7 | C1 | CAP_ELEC_6.3x7.7 | C2887275
10uF 50V X7R 1206 | C2,C3 | 1206 | C303950
100nF 50V X7R 0603 | C4,C5,C6,C7,C8,C9,C10,C14,C17,C18,C19,C23,C26,C30,C31 | 0603 | C14663
1uF 50V X5R 0603 | C11,C12,C20,C22 | 0603 | C15849
47nF 50V X7R 0402 | C13 | 0402 | C307339
22uF 25V X5R 0805 | C15 | 0805 | C45783
4.7uF 16V X5R 0603 | C16 | 0603 | C19666
10nF 50V X7R 0603 | C21 | 0603 | C57112
20pF 50V C0G 0603 | C24,C25 | 0603 | C1648
220pF 50V X7R 0603 | C27,C28,C29 | 0603 | C1603
BZT52C10 | D1 | SOD-123 | C2103
SMBJ18A | D2 | SMB | C10212
BZT52C3V3 | D3 | SOD-123 | C173413
LED yellow-green 0603 KT-0603YG | D4,D5 | 0603 | C2289
SMD1812P150TF/24 | F1 | 1812 | C32404
Ferrite 600R@100MHz 0603 | FB1 | 0603 | C1002
SM04B-GHS-TB | J2 | JST_GH_SM04B | C189895
SMNR5040-470MT 47uH | L1 | SMNR5040 | C9392
AO3401A | Q1 | SOT-23 | C15127
10k 1% 0603 | R1,R3,R5,R7,R8 | 0603 | C25804
100k 1% 0603 | R2 | 0603 | C25803
0R 0603 | R4,R9 | 0603 | C21189
5.1k 1% 0603 | R6 | 0603 | C23186
330R 1% 0603 | R10,R12,R13 | 0603 | C23138
1k 1% 0603 | R11,R15 | 0603 | C21190
120R 1% 0603 | R14 | 0603 | C22787
DRV8316CRRGFR | U1 | VQFN-40 | C5447274
STM32G431CBT6 | U2 | LQFP-48 | C529355
MT6701CT-STD | U3 | SOP-8 | C3003196
SN65HVD230DR | U4 | SOIC-8 | C12084
X50328MSB2GI 8MHz | Y1 | 5032 | C115962
