Xxfliph/cycloidal-foc-actuator/hardware/fab/actuator-driver_BOM_PCBWay.csv

Item | Designator | Qty | Manufacturer | Manufacturer Part Number | Description | Package
1 | C1 | 1 | KNSCHA | RVT47UF50V67RV0029 | 47uF 50V electrolytic 6.3x7.7 | SMD 6.3x7.7
2 | C2,C3 | 2 | FH | 1206B106K500NT | 10uF 50V X7R | 1206
3 | C4,C5,C6,C7,C8,C9,C10,C14,C17,C18,C19,C23,C26,C30,C31 | 15 | YAGEO | CC0603KRX7R9BB104 | 100nF 50V X7R | 0603
4 | C11,C12,C20,C22 | 4 | Samsung | CL10A105KB8NNNC | 1uF 50V X5R | 0603
5 | C13 | 1 | Samsung | CL05B473KB5VPNC | 47nF 50V X7R | 0402
6 | C15 | 1 | Samsung | CL21A226MAQNNNE | 22uF 25V X5R | 0805
7 | C16 | 1 | Samsung | CL10A475KO8NNNC | 4.7uF 16V X5R | 0603
8 | C21 | 1 | FH | 0603B103K500NT | 10nF 50V X7R | 0603
9 | C24,C25 | 2 | Samsung | CL10C200JB8NNNC | 20pF 50V C0G | 0603
10 | C27,C28,C29 | 3 | Samsung | CL10B221KB8NNNC | 220pF 50V X7R | 0603
11 | D1 | 1 | Changjing | BZT52C10 | Zener 10V | SOD-123
12 | D2 | 1 | RUILON | SMBJ18A | TVS 18V unidirectional | SMB
13 | D3 | 1 | MDD | BZT52C3V3 | Zener 3.3V | SOD-123
14 | D4,D5 | 2 | Hubei KENTO | KT-0603YG | LED yellow-green | 0603
15 | F1 | 1 | RUILON | SMD1812P150TF/24 | PTC 1.5A hold 24V | 1812
16 | FB1 | 1 | Sunlord | GZ1608D601TF | Ferrite 600R@100MHz | 0603
17 | J2 | 1 | JST | SM04B-GHS-TB(LF)(SN) | GH 4-pin SMD right angle | SMD
18 | L1 | 1 | SXN | SMNR5040-470MT | 47uH shielded 1.1A | 5040
19 | Q1 | 1 | AOS | AO3401A | P-MOSFET -30V | SOT-23
20 | R1,R3,R5,R7,R8 | 5 | UNI-ROYAL | 0603WAF1002T5E | 10k 1% | 0603
21 | R2 | 1 | UNI-ROYAL | 0603WAF1003T5E | 100k 1% | 0603
22 | R4,R9 | 2 | UNI-ROYAL | 0603WAF0000T5E | 0R | 0603
23 | R6 | 1 | UNI-ROYAL | 0603WAF5101T5E | 5.1k 1% | 0603
24 | R10,R12,R13 | 3 | UNI-ROYAL | 0603WAF3300T5E | 330R 1% | 0603
25 | R11,R15 | 2 | UNI-ROYAL | 0603WAF1001T5E | 1k 1% | 0603
26 | R14 | 1 | UNI-ROYAL | 0603WAF1200T5E | 120R 1% | 0603
27 | U1 | 1 | Texas Instruments | DRV8316CRRGFR | 3-phase motor driver SPI | VQFN-40 (RGF)
28 | U2 | 1 | STMicroelectronics | STM32G431CBT6 | MCU | LQFP-48
29 | U3 | 1 | MagnTek | MT6701CT-STD | Magnetic angle sensor | SOP-8
30 | U4 | 1 | Texas Instruments | SN65HVD230DR | CAN transceiver | SOIC-8
31 | Y1 | 1 | YXC | X50328MSB2GI | 8MHz crystal 20pF | SMD5032-2P
