Xxfliph/cycloidal-foc-actuator/hardware/outline/board-outline.dxf

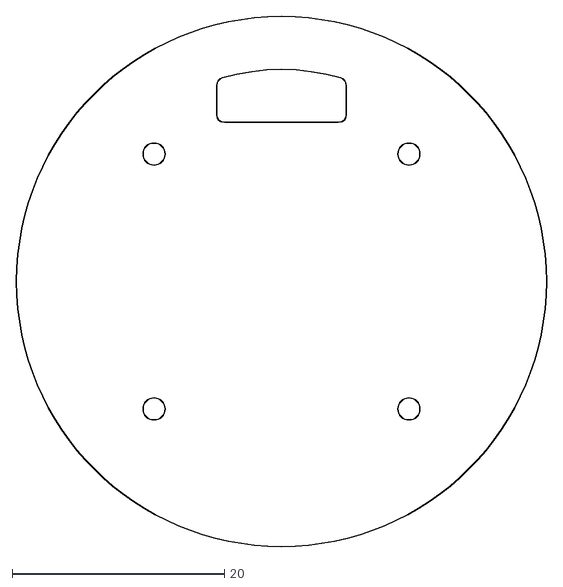
[picture p8: CAD file, 2026-11-07]
hardware/outline/board-outline.dxf
50.0 x 50.0
