Xxfliph/cycloidal-foc-actuator/mechanical/encoder magnet holder/encoder magnet holder.step

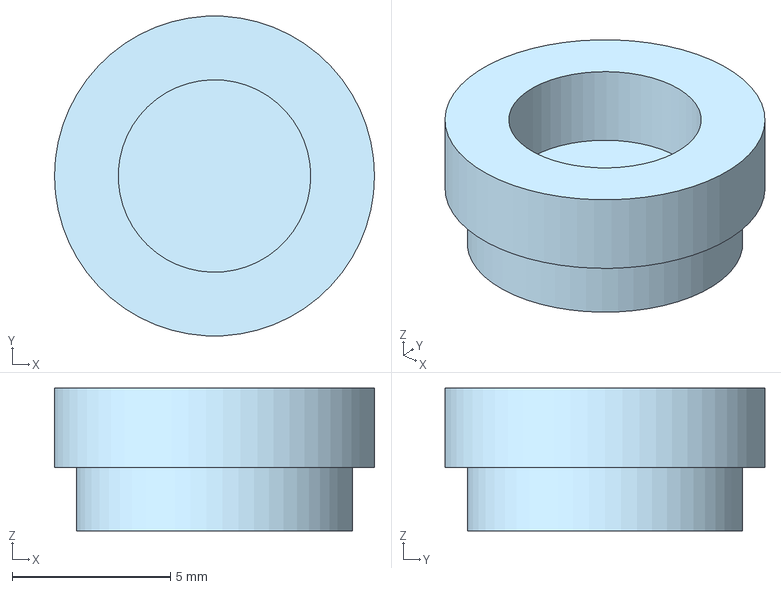
[picture p9: CAD file, 2026-11-06]
mechanical/encoder magnet holder/encoder magnet holder.step
10.1 x 10.1 x 4.50 mm
