Xxfliph/cycloidal-foc-actuator/hardware/outline/board-on-motor.step

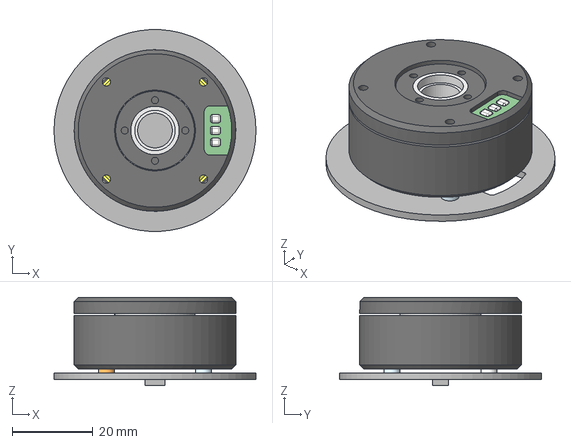
[picture p10: CAD file, 2026-11-07]
hardware/outline/board-on-motor.step
50.0 x 49.9 x 21.9 mm
