Xxfliph/cycloidal-foc-actuator/(list of files, cad)

Other CAD files:
mechanical/encoder magnet holder/encoder magnet holder.SLDPRT
