Xxfliph/cycloidal-foc-actuator/docs/img/Kp = 0.3, Ki = 3.0 final tuning zoomed in.png

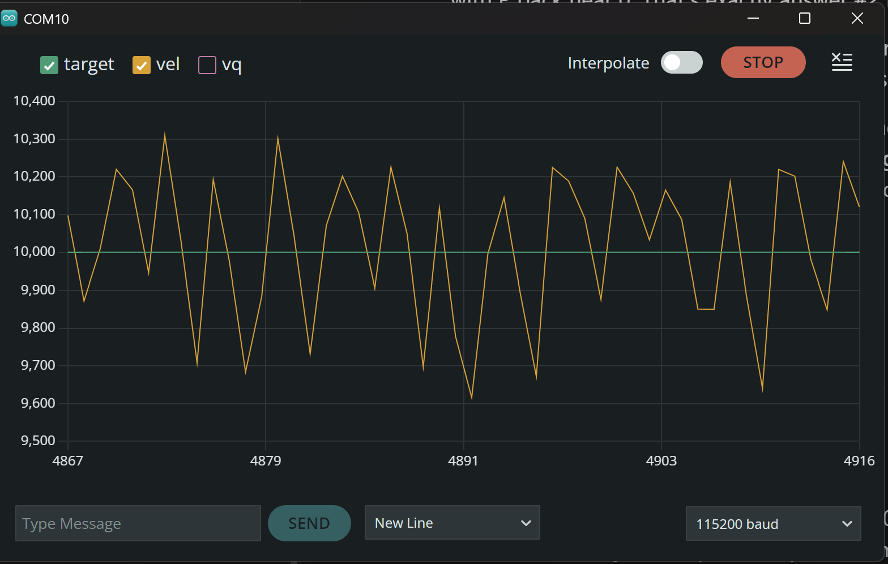
docs/img/Kp = 0.3, Ki = 3.0 final tuning zoomed in.png
