Xxfliph/cycloidal-foc-actuator/(list of files, drawings)

Other design files:
hardware/altium/actuator-driver/2_drv8316.SchDoc
hardware/altium/actuator-driver/3_mcu.SchDoc
hardware/altium/actuator-driver/4_encoder.SchDoc
hardware/altium/actuator-driver/5_can.SchDoc
hardware/altium/actuator-driver/6_connectors.SchDoc
hardware/altium/actuator-driver/actuator-driver.PcbDoc
hardware/altium/actuator-driver/actuator-driver.PcbLib
hardware/altium/actuator-driver/actuator-driver.PrjPcb
hardware/altium/actuator-driver/actuator-driver.SchDoc
hardware/altium/actuator-driver/actuator-driver.SchLib
