Xxfliph/cycloidal-foc-actuator/hardware/pinplan/pinplan.ioc

Mcu.UserName=STM32G431CBTx
PA0.Signal=ADC1_IN1
PA1.Signal=ADC1_IN2
PA10.Signal=S_TIM1_CH3
PA11.Signal=USB_DM
PA12.Signal=USB_DP
PA13.Signal=SYS_JTMS-SWDIO
PA14.Signal=SYS_JTCK-SWCLK
PA15.GPIO_Label=DRV_CS
PA15.Signal=GPIO_Output
PA2.Signal=ADC1_IN3
PA3.Signal=ADC1_IN4
PA8.Signal=S_TIM1_CH1
PA9.Signal=S_TIM1_CH2
PB0.GPIO_Label=DRV_OFF
PB0.Signal=GPIO_Output
PB1.GPIO_Label=PHASE_EN
PB1.Signal=GPIO_Output
PB10.GPIO_Label=LED
PB10.Signal=GPIO_Output
PB11.GPIO_Label=DRV_FAULT
PB11.Signal=GPXTI11
PB12.GPIO_Label=ENC_CS
PB12.Signal=GPIO_Output
PB13.Signal=SPI2_SCK
PB14.Signal=SPI2_MISO
PB3.Signal=SPI3_SCK
PB4.Signal=SPI3_MISO
PB5.Signal=SPI3_MOSI
PB8-BOOT0.Signal=FDCAN1_RX
PB9.Signal=FDCAN1_TX
PF0-OSC_IN.Signal=RCC_OSC_IN
PF1-OSC_OUT.Signal=RCC_OSC_OUT
