Xxfliph/cycloidal-foc-actuator/firmware/actuator_fw/Core/Inc/main.h

#define DRV_EN_Pin GPIO_PIN_0
#define DRV_EN_GPIO_Port GPIOB
#define LED_Pin GPIO_PIN_6
#define LED_GPIO_Port GPIOC
