Xxfliph/cycloidal-foc-actuator/firmware/actuator_fw/Core/Inc/motor_driver.h

/*
 * motor_driver.h
 *
 *  Created on: Nov 1, 2026
 *      Author: jonny
 */

#ifndef INC_MOTOR_DRIVER_H_
#define INC_MOTOR_DRIVER_H_
#include "main.h"

class MotorDriver {

public:
	MotorDriver(TIM_HandleTypeDef* htim, GPIO_TypeDef* enPort,uint16_t enPin);
	void start();
	void setDuty(const float duty[3]);
	void enable();
	void disable();

private:
    TIM_HandleTypeDef* htim_;
    GPIO_TypeDef* enPort_;
    uint16_t enPin_;

};


#endif /* INC_MOTOR_DRIVER_H_ */
