Xxfliph/cycloidal-foc-actuator/(commit log)

2026-10-30 firmware: CubeMX G474 project, 170 MHz HSE clock, LED blink
2026-10-30 firmware: TIM1 center-aligned 3-phase PWM at 24 kHz, verified on logic analyzer
2026-10-31 firmware: I2C1 400 kHz on PA15/PB7, MT6701 found at 0x06
2026-11-02 firmware: FocController (SVPWM) and MotorDriver classes, verified duty waveforms on serial plotter
2026-11-03 C Encoder class; verify raw angle read and wrap
2026-11-03 Encoder: add radians, multi-turn unwrap
2026-11-03 Encoder: Velocity from DWT cycle counter
2026-11-03 Encoder: EMA low-pass velocity filter (tau = 20 ms)
2026-11-03 Log: MT6701 Encoder class, multi-turn, velocity + filter
2026-11-03 Calibration at vd 2.5 V + 4-angle hold check (offset/direction/pole pairs verified)
2026-11-04 Closed-loop voltage-mode FOC (vq const) with calibration + encoder-fault cutoff
2026-11-04 Add PIController with anti-windup; default-initialize FocController calibration
2026-11-04 Log: first spin, calibration, closed-loop code, magnet choice, PI controller class
2026-11-04 Add velocity PI loop with step command and constant-vq/velocity mode switch
2026-11-05 Tune velocity loop: Kp 0.3, Ki 3
2026-11-05 Add closed-loop and velocity tuning plots
2026-11-05 Add log entry: Velocity loop, closed-loop FOC on hardware, tuning
2026-11-06 Add PCB requirements draft
2026-11-06 Fix PCB requirements draft
2026-11-06 PCB prep: requirements, parts, CubeMX pin plan, encoder magnet sleeve CAD
    [encoder magnet holder.SLDPRT, encoder magnet holder.step]
2026-11-07 Altium project: board outline + mounting holes
    [actuator-driver.PcbDoc, actuator-driver.PrjPcb, actuator-driver.SchDoc, board-on-motor.step, board-outline.dxf]
2026-11-07 Log: Motor measurements, board outline, Altium project
    [actuator-driver.PcbDoc]
2026-11-07 Add DRV8316C symbol and footprint, fixed to TI land pattern
    [actuator-driver.PcbLib, actuator-driver.SchLib]
2026-11-07 Add STM32G431CBT6 symbol and footprint
    [actuator-driver.PcbLib, actuator-driver.SchLib]
2026-11-07 Add SN65HVD230DR symbol and footprint
    [actuator-driver.PcbLib, actuator-driver.SchLib]
2026-11-07 Add MT6701CT-STD symbol (reuses SOIC-8 D0008A footprint)
    [actuator-driver.SchLib]
2026-11-07 Add AO3401A symbol and footprint (AOS SOT-23 land pattern)
    [actuator-driver.PcbLib, actuator-driver.SchLib]
2026-11-07 Add BZT52C3V3, BZT52C10 (SOD-123, MDD pad layout); rename AO3401A and SMBJ18A
    [actuator-driver.PcbLib, actuator-driver.PrjPcb, actuator-driver.SchLib]
2026-11-08 Add SMD1812P150TF/24 PTC fuse (RUILON pad layout)
    [actuator-driver.PcbLib, actuator-driver.SchLib]
2026-11-08 Add X50328MSB2GI crystal
    [actuator-driver.PcbLib, actuator-driver.SchLib]
2026-11-08 Add SMNR5040-470MT 47 uH inductor
    [actuator-driver.PcbLib, actuator-driver.SchLib]
2026-11-08 Add RVT47UF50V67RV0029 47 uF electrolytic
    [actuator-driver.PcbLib, actuator-driver.SchLib]
2026-11-08 Add KF350-3.5-2P screw terminal (replaces XT30)
    [actuator-driver.PcbLib, actuator-driver.SchLib]
2026-11-08 Add SM04B-GHS-TB JST GH CAN connector
    [actuator-driver.PcbLib, actuator-driver.SchLib]
2026-11-08 Add generic RES_0603 and CAP_0603/0805/1206 parts
    [actuator-driver.PcbLib, actuator-driver.SchLib]
2026-11-08 Add generic LED_0603
    [actuator-driver.PcbLib, actuator-driver.SchLib]
2026-11-08 Add FB_0603, SWD header, test pad and solder jumper parts
    [actuator-driver.PcbLib, actuator-driver.SchLib]
2026-11-08 Add motor phase solder pads
    [actuator-driver.PcbLib, actuator-driver.SchLib]
2026-11-08 Claude review: double-check and fix parts, pin plan and schematic/PCB libraries.
    [actuator-driver.SchLib]
2026-11-09 Schematic done: 6 sheets, compile clean
    [2_drv8316.SchDoc, 3_mcu.SchDoc, 4_encoder.SchDoc, 5_can.SchDoc, 6_connectors.SchDoc, actuator-driver.PcbDoc, actuator-driver.PrjPcb, actuator-driver.SchDoc]
2026-11-09 Log: Update entry for PCB Schematics
2026-11-10 PCB placement before review fixes
    [2_drv8316.SchDoc, actuator-driver.PcbDoc]
2026-11-10 PCB placement review fixes; C13 to 0402 (CAP_0402 footprint+symbol)
    [2_drv8316.SchDoc, 3_mcu.SchDoc, 4_encoder.SchDoc, 5_can.SchDoc, 6_connectors.SchDoc, actuator-driver.PcbDoc, actuator-driver.PcbLib, actuator-driver.SchDoc]
2026-11-10 PCB placement review fixes
    [actuator-driver.PcbDoc]
2026-11-11 hardware: 4-layer JLC 3313 stackup, net classes, design rules, mounting-hole keepouts
    [actuator-driver.PcbDoc]
2026-11-11 hardware: L2/L4 GND pours with PGND island
    [actuator-driver.PcbDoc]
2026-11-11 hardware: add U1 pin-1 dot
    [actuator-driver.PcbDoc]
2026-11-11 PCB: stackup, rules, pours; route sections 1-5
    [actuator-driver.PcbDoc]
2026-11-12 PCB routing, review, fix changes, export filesfor manufacturing
    [actuator-driver.PcbDoc, actuator-driver_BOM_JLC.csv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]
2026-11-12 PCB routed, fabrication files back up before via annular ring fix
    [actuator-driver.PcbDoc, actuator-driver.PrjPcb, actuator-driver_BOM_JLC.csv, actuator-driver_BOM_PCBWay.csv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]
2026-11-13 Final Review fixes, final fab files for JLC order, update log
    [actuator-driver.PcbDoc, actuator-driver.PrjPcb, actuator-driver_BOM_JLC.csv, actuator-driver_BOM_PCBWay.csv]
