Xxfliph/cycloidal-foc-actuator/(notices)

Notices in the files:
firmware/actuator_fw/Core/Inc/main.h:
Copyright (c) 2026 STMicroelectronics.
All rights reserved.
This software is licensed under terms that can be found in the LICENSE file
